Toshi2020/Bluetooth-Digital-Caliper/(list of files, cad)

Other CAD files:
CaliperBLE_All.f3d
